YihuiCalm/Neural_Spike_Detection_and_Sorting_Circuit/schematics/simulation/amp_tb.spice

**.subckt amp_tb
VDD VDD GND 5v
v1 vbias GND 1v
Vin vin GND SIN(1 1 0.1G 0 0)
Vmeas vout net1 0
v2 vref GND 2v
XM1 GND vin net1 VDD sky130_fd_pr__pfet_g5v0d10v5 L=1 W=1 nf=1 ad='int((nf+1)/2) * W/nf * 0.29' as='int((nf+2)/2) * W/nf * 0.29'
+ pd='2*int((nf+1)/2) * (W/nf + 0.29)' ps='2*int((nf+2)/2) * (W/nf + 0.29)' nrd='0.29 / W' nrs='0.29 / W'
+ sa=0 sb=0 sd=0 mult=1 m=1 
X1 VDD vout vout vbias transamp_1
**** begin user architecture code


.control
save all
tran 1ns 50ns
plot v(vin) v(vout)
plot i(Vmeas)
.endc


 .lib /home/ubuntulab/IC/PDK/skywater-pdk/libraries/sky130_fd_pr_ngspice/latest/models/sky130.lib.spice tt

.param mc_mm_switch=0
.param mc_pr_switch=1

**** end user architecture code
**.ends

* expanding   symbol:  /media/sf_share/final_project/transamp_1.sym # of pins=4
* sym_path: /media/sf_share/final_project/transamp_1.sym
* sch_path: /media/sf_share/final_project/transamp_1.sch
.subckt transamp_1  vin_p vin_n IVout vbias
*.opin IVout
*.ipin vin_p
*.ipin vin_n
*.ipin vbias
XM1 net1 vbias GND GND sky130_fd_pr__nfet_g5v0d10v5 L=1 W=1 nf=1 ad='int((nf+1)/2) * W/nf * 0.29' as='int((nf+2)/2) * W/nf * 0.29'
+ pd='2*int((nf+1)/2) * (W/nf + 0.29)' ps='2*int((nf+2)/2) * (W/nf + 0.29)' nrd='0.29 / W' nrs='0.29 / W'
+ sa=0 sb=0 sd=0 mult=1 m=1 
XM3 net2 vin_p net1 GND sky130_fd_pr__nfet_g5v0d10v5 L=1 W=1 nf=1 ad='int((nf+1)/2) * W/nf * 0.29' as='int((nf+2)/2) * W/nf * 0.29'
+ pd='2*int((nf+1)/2) * (W/nf + 0.29)' ps='2*int((nf+2)/2) * (W/nf + 0.29)' nrd='0.29 / W' nrs='0.29 / W'
+ sa=0 sb=0 sd=0 mult=1 m=1 
XM4 IVout net2 VDD VDD sky130_fd_pr__pfet_g5v0d10v5 L=1 W=1 nf=1 ad='int((nf+1)/2) * W/nf * 0.29' as='int((nf+2)/2) * W/nf * 0.29'
+ pd='2*int((nf+1)/2) * (W/nf + 0.29)' ps='2*int((nf+2)/2) * (W/nf + 0.29)' nrd='0.29 / W' nrs='0.29 / W'
+ sa=0 sb=0 sd=0 mult=1 m=1 
XM2 IVout vin_n net1 GND sky130_fd_pr__nfet_g5v0d10v5 L=1 W=1 nf=1 ad='int((nf+1)/2) * W/nf * 0.29' as='int((nf+2)/2) * W/nf * 0.29'
+ pd='2*int((nf+1)/2) * (W/nf + 0.29)' ps='2*int((nf+2)/2) * (W/nf + 0.29)' nrd='0.29 / W' nrs='0.29 / W'
+ sa=0 sb=0 sd=0 mult=1 m=1 
XM5 net2 net2 VDD VDD sky130_fd_pr__pfet_g5v0d10v5 L=1 W=1 nf=1 ad='int((nf+1)/2) * W/nf * 0.29' as='int((nf+2)/2) * W/nf * 0.29'
+ pd='2*int((nf+1)/2) * (W/nf + 0.29)' ps='2*int((nf+2)/2) * (W/nf + 0.29)' nrd='0.29 / W' nrs='0.29 / W'
+ sa=0 sb=0 sd=0 mult=1 m=1 
.ends

.GLOBAL VDD
.GLOBAL GND
** flattened .save nodes
.save I(Vmeas)
.end
