YihuiCalm/Neural_Spike_Detection_and_Sorting_Circuit/schematics/simulation/and_tb.spice

**.subckt and_tb
Vin a GND PULSE(0 5 0 0 0 5ns 10ns)
VDD VDD GND 5v
x1 net1 a b and
Vin1 b GND PULSE(0 5 0 0 0 8ns 16ns)
x2 vout net2 schmitt_trigger
R1 net1 net2 2k m=1
R2 net2 GND 30k m=1
**** begin user architecture code


.control
save all
tran 1ns 50ns
plot v(a) v(b) v(vout)
.endc


 .lib /home/ubuntulab/IC/PDK/skywater-pdk/libraries/sky130_fd_pr_ngspice/latest/models/sky130.lib.spice tt

.param mc_mm_switch=0
.param mc_pr_switch=1

**** end user architecture code
**.ends

* expanding   symbol:  /media/sf_share/final_project/and.sym # of pins=3
* sym_path: /media/sf_share/final_project/and.sym
* sch_path: /media/sf_share/final_project/and.sch
.subckt and  vout a b
*.ipin a
*.opin vout
*.ipin b
XM1 net1 b GND GND sky130_fd_pr__nfet_g5v0d10v5 L=0.5 W=0.5 nf=1 ad='int((nf+1)/2) * W/nf * 0.29' as='int((nf+2)/2) * W/nf * 0.29'
+ pd='2*int((nf+1)/2) * (W/nf + 0.29)' ps='2*int((nf+2)/2) * (W/nf + 0.29)' nrd='0.29 / W' nrs='0.29 / W'
+ sa=0 sb=0 sd=0 mult=1 m=1 
XM5 net2 a net1 GND sky130_fd_pr__nfet_g5v0d10v5 L=0.5 W=0.5 nf=1 ad='int((nf+1)/2) * W/nf * 0.29' as='int((nf+2)/2) * W/nf * 0.29'
+ pd='2*int((nf+1)/2) * (W/nf + 0.29)' ps='2*int((nf+2)/2) * (W/nf + 0.29)' nrd='0.29 / W' nrs='0.29 / W'
+ sa=0 sb=0 sd=0 mult=1 m=1 
XM2 net2 a VDD VDD sky130_fd_pr__pfet_g5v0d10v5 L=0.5 W=0.5 nf=1 ad='int((nf+1)/2) * W/nf * 0.29' as='int((nf+2)/2) * W/nf * 0.29'
+ pd='2*int((nf+1)/2) * (W/nf + 0.29)' ps='2*int((nf+2)/2) * (W/nf + 0.29)' nrd='0.29 / W' nrs='0.29 / W'
+ sa=0 sb=0 sd=0 mult=1 m=1 
XM4 net2 b VDD VDD sky130_fd_pr__pfet_g5v0d10v5 L=0.5 W=0.5 nf=1 ad='int((nf+1)/2) * W/nf * 0.29' as='int((nf+2)/2) * W/nf * 0.29'
+ pd='2*int((nf+1)/2) * (W/nf + 0.29)' ps='2*int((nf+2)/2) * (W/nf + 0.29)' nrd='0.29 / W' nrs='0.29 / W'
+ sa=0 sb=0 sd=0 mult=1 m=1 
x1 vout net2 inverter
.ends


* expanding   symbol:  /media/sf_share/final_project/schmitt_trigger.sym # of pins=2
* sym_path: /media/sf_share/final_project/schmitt_trigger.sym
* sch_path: /media/sf_share/final_project/schmitt_trigger.sch
.subckt schmitt_trigger  vout vin
*.ipin vin
*.opin vout
XM1 net1 vin net3 GND sky130_fd_pr__nfet_g5v0d10v5 L=1 W=15 nf=1 ad='int((nf+1)/2) * W/nf * 0.29' as='int((nf+2)/2) * W/nf * 0.29'
+ pd='2*int((nf+1)/2) * (W/nf + 0.29)' ps='2*int((nf+2)/2) * (W/nf + 0.29)' nrd='0.29 / W' nrs='0.29 / W'
+ sa=0 sb=0 sd=0 mult=1 m=1 
XM2 net1 vin net2 VDD sky130_fd_pr__pfet_g5v0d10v5 L=1 W=15 nf=1 ad='int((nf+1)/2) * W/nf * 0.29' as='int((nf+2)/2) * W/nf * 0.29'
+ pd='2*int((nf+1)/2) * (W/nf + 0.29)' ps='2*int((nf+2)/2) * (W/nf + 0.29)' nrd='0.29 / W' nrs='0.29 / W'
+ sa=0 sb=0 sd=0 mult=1 m=1 
XM3 net2 vin VDD VDD sky130_fd_pr__pfet_g5v0d10v5 L=1 W=1.5 nf=1 ad='int((nf+1)/2) * W/nf * 0.29' as='int((nf+2)/2) * W/nf * 0.29'
+ pd='2*int((nf+1)/2) * (W/nf + 0.29)' ps='2*int((nf+2)/2) * (W/nf + 0.29)' nrd='0.29 / W' nrs='0.29 / W'
+ sa=0 sb=0 sd=0 mult=1 m=1 
XM4 net3 vin GND GND sky130_fd_pr__nfet_g5v0d10v5 L=1 W=1.05 nf=1 ad='int((nf+1)/2) * W/nf * 0.29' as='int((nf+2)/2) * W/nf * 0.29'
+ pd='2*int((nf+1)/2) * (W/nf + 0.29)' ps='2*int((nf+2)/2) * (W/nf + 0.29)' nrd='0.29 / W' nrs='0.29 / W'
+ sa=0 sb=0 sd=0 mult=1 m=1 
XM5 GND net1 net2 VDD sky130_fd_pr__pfet_g5v0d10v5 L=15 W=1 nf=1 ad='int((nf+1)/2) * W/nf * 0.29' as='int((nf+2)/2) * W/nf * 0.29'
+ pd='2*int((nf+1)/2) * (W/nf + 0.29)' ps='2*int((nf+2)/2) * (W/nf + 0.29)' nrd='0.29 / W' nrs='0.29 / W'
+ sa=0 sb=0 sd=0 mult=1 m=1 
XM6 VDD net1 net3 GND sky130_fd_pr__nfet_g5v0d10v5 L=5.5 W=1 nf=1 ad='int((nf+1)/2) * W/nf * 0.29' as='int((nf+2)/2) * W/nf * 0.29'
+ pd='2*int((nf+1)/2) * (W/nf + 0.29)' ps='2*int((nf+2)/2) * (W/nf + 0.29)' nrd='0.29 / W' nrs='0.29 / W'
+ sa=0 sb=0 sd=0 mult=1 m=1 
x1 vout net1 inverter
.ends


* expanding   symbol:  /media/sf_share/final_project/inverter.sym # of pins=2
* sym_path: /media/sf_share/final_project/inverter.sym
* sch_path: /media/sf_share/final_project/inverter.sch
.subckt inverter  vout vin
*.ipin vin
*.opin vout
XM3 vout vin VDD VDD sky130_fd_pr__pfet_g5v0d10v5 L=1 W=1 nf=1 ad='int((nf+1)/2) * W/nf * 0.29' as='int((nf+2)/2) * W/nf * 0.29'
+ pd='2*int((nf+1)/2) * (W/nf + 0.29)' ps='2*int((nf+2)/2) * (W/nf + 0.29)' nrd='0.29 / W' nrs='0.29 / W'
+ sa=0 sb=0 sd=0 mult=1 m=1 
XM5 vout vin GND GND sky130_fd_pr__nfet_g5v0d10v5 L=1 W=1 nf=1 ad='int((nf+1)/2) * W/nf * 0.29' as='int((nf+2)/2) * W/nf * 0.29'
+ pd='2*int((nf+1)/2) * (W/nf + 0.29)' ps='2*int((nf+2)/2) * (W/nf + 0.29)' nrd='0.29 / W' nrs='0.29 / W'
+ sa=0 sb=0 sd=0 mult=1 m=1 
.ends

.GLOBAL VDD
.GLOBAL GND
** flattened .save nodes
.end
