YihuiCalm/Neural_Spike_Detection_and_Sorting_Circuit/schematics/simulation/bump_WTA_tb.spice

**.subckt bump_WTA_tb
V2 net39 GND 5.0
V5 HPbias GND 0.4
V6 VREF GND 2.0
V3 LPbias1 GND 0.543v
V4 LPbias2 GND 0.4v
Vbias5 vbias_bump GND 3v
Vbias6 vbias_WTA GND 3v
x6 vin_1 net1 HPbias VREF Highpass_500Hz
x7 LPbias2 net1 vfilter_1 LPbias1 Lowpass_2500Hz
x8 vspike_1 vfilter_1 schmitt_trigger
x9 vin_2 net2 HPbias VREF Highpass_500Hz
x10 LPbias2 net2 vfilter_2 LPbias1 Lowpass_2500Hz
x11 vspike_2 vfilter_2 schmitt_trigger
x12 vin_3 net3 HPbias VREF Highpass_500Hz
x13 LPbias2 net3 vfilter_3 LPbias1 Lowpass_2500Hz
x14 vspike_3 vfilter_3 schmitt_trigger
x15 vin_4 net4 HPbias VREF Highpass_500Hz
x16 LPbias2 net4 vfilter_4 LPbias1 Lowpass_2500Hz
x17 vspike_4 vfilter_4 schmitt_trigger
x18 vmem_1_1 vg_1 vspike_1 vbias vbias1 vbias2 cap_mem
x1 vmem_2_1 vg_1 vspike_2 vbias vbias1 vbias2 cap_mem
x2 vmem_3_1 vg_1 vspike_3 vbias vbias1 vbias2 cap_mem
x3 vmem_4_1 vg_1 vspike_4 vbias vbias1 vbias2 cap_mem
Vmeas_bump_1 net40 net5 0
XM8 net5 net6 GND GND sky130_fd_pr__nfet_g5v0d10v5 L=1 W=1 nf=1 ad='int((nf+1)/2) * W/nf * 0.29' as='int((nf+2)/2) * W/nf * 0.29'
+ pd='2*int((nf+1)/2) * (W/nf + 0.29)' ps='2*int((nf+2)/2) * (W/nf + 0.29)' nrd='0.29 / W' nrs='0.29 / W'
+ sa=0 sb=0 sd=0 mult=1 m=1 
XM9 VDD net5 net6 GND sky130_fd_pr__nfet_g5v0d10v5 L=1 W=1 nf=1 ad='int((nf+1)/2) * W/nf * 0.29' as='int((nf+2)/2) * W/nf * 0.29'
+ pd='2*int((nf+1)/2) * (W/nf + 0.29)' ps='2*int((nf+2)/2) * (W/nf + 0.29)' nrd='0.29 / W' nrs='0.29 / W'
+ sa=0 sb=0 sd=0 mult=1 m=1 
XM10 net7 net8 GND GND sky130_fd_pr__nfet_g5v0d10v5 L=1 W=1 nf=1 ad='int((nf+1)/2) * W/nf * 0.29' as='int((nf+2)/2) * W/nf * 0.29'
+ pd='2*int((nf+1)/2) * (W/nf + 0.29)' ps='2*int((nf+2)/2) * (W/nf + 0.29)' nrd='0.29 / W' nrs='0.29 / W'
+ sa=0 sb=0 sd=0 mult=1 m=1 
XM11 VDD net7 net8 GND sky130_fd_pr__nfet_g5v0d10v5 L=1 W=1 nf=1 ad='int((nf+1)/2) * W/nf * 0.29' as='int((nf+2)/2) * W/nf * 0.29'
+ pd='2*int((nf+1)/2) * (W/nf + 0.29)' ps='2*int((nf+2)/2) * (W/nf + 0.29)' nrd='0.29 / W' nrs='0.29 / W'
+ sa=0 sb=0 sd=0 mult=1 m=1 
I0 VDD net7 8uA
XM12 net10 vbias_WTA GND GND sky130_fd_pr__nfet_g5v0d10v5 L=1 W=1 nf=1 ad='int((nf+1)/2) * W/nf * 0.29'
+ as='int((nf+2)/2) * W/nf * 0.29' pd='2*int((nf+1)/2) * (W/nf + 0.29)' ps='2*int((nf+2)/2) * (W/nf + 0.29)'
+ nrd='0.29 / W' nrs='0.29 / W' sa=0 sb=0 sd=0 mult=1 m=1 
Vmeas_in_1 net6 net9 0
Vmeas_ref net8 net9 0
Vmeas_bais net9 net10 0
x5 vmem_1_1 vnxor_1_1 vspike_1 nxor
XM6 net12 VDD net13 GND sky130_fd_pr__nfet_g5v0d10v5 L=1 W=0.5 nf=1 ad='int((nf+1)/2) * W/nf * 0.29'
+ as='int((nf+2)/2) * W/nf * 0.29' pd='2*int((nf+1)/2) * (W/nf + 0.29)' ps='2*int((nf+2)/2) * (W/nf + 0.29)'
+ nrd='0.29 / W' nrs='0.29 / W' sa=0 sb=0 sd=0 mult=1 m=1 
XM7 VDD vand_1 net11 GND sky130_fd_pr__nfet_g5v0d10v5 L=1 W=1 nf=1 ad='int((nf+1)/2) * W/nf * 0.29' as='int((nf+2)/2) * W/nf * 0.29'
+ pd='2*int((nf+1)/2) * (W/nf + 0.29)' ps='2*int((nf+2)/2) * (W/nf + 0.29)' nrd='0.29 / W' nrs='0.29 / W'
+ sa=0 sb=0 sd=0 mult=1 m=1 
XM2 net13 vand_1 net11 GND sky130_fd_pr__nfet_g5v0d10v5 L=1 W=0.5 nf=1 ad='int((nf+1)/2) * W/nf * 0.29'
+ as='int((nf+2)/2) * W/nf * 0.29' pd='2*int((nf+1)/2) * (W/nf + 0.29)' ps='2*int((nf+2)/2) * (W/nf + 0.29)'
+ nrd='0.29 / W' nrs='0.29 / W' sa=0 sb=0 sd=0 mult=1 m=1 
XM3 VDD VDD net11 GND sky130_fd_pr__nfet_g5v0d10v5 L=1 W=1 nf=1 ad='int((nf+1)/2) * W/nf * 0.29' as='int((nf+2)/2) * W/nf * 0.29'
+ pd='2*int((nf+1)/2) * (W/nf + 0.29)' ps='2*int((nf+2)/2) * (W/nf + 0.29)' nrd='0.29 / W' nrs='0.29 / W'
+ sa=0 sb=0 sd=0 mult=1 m=1 
XM4 net11 vbias_bump GND GND sky130_fd_pr__nfet_g5v0d10v5 L=1 W=1 nf=1 ad='int((nf+1)/2) * W/nf * 0.29'
+ as='int((nf+2)/2) * W/nf * 0.29' pd='2*int((nf+1)/2) * (W/nf + 0.29)' ps='2*int((nf+2)/2) * (W/nf + 0.29)'
+ nrd='0.29 / W' nrs='0.29 / W' sa=0 sb=0 sd=0 mult=1 m=1 
XM5 net12 net12 VDD VDD sky130_fd_pr__pfet_g5v0d10v5 L=1 W=1 nf=1 ad='int((nf+1)/2) * W/nf * 0.29' as='int((nf+2)/2) * W/nf * 0.29'
+ pd='2*int((nf+1)/2) * (W/nf + 0.29)' ps='2*int((nf+2)/2) * (W/nf + 0.29)' nrd='0.29 / W' nrs='0.29 / W'
+ sa=0 sb=0 sd=0 mult=1 m=1 
XM1 net40 net12 VDD VDD sky130_fd_pr__pfet_g5v0d10v5 L=1 W=1 nf=1 ad='int((nf+1)/2) * W/nf * 0.29' as='int((nf+2)/2) * W/nf * 0.29'
+ pd='2*int((nf+1)/2) * (W/nf + 0.29)' ps='2*int((nf+2)/2) * (W/nf + 0.29)' nrd='0.29 / W' nrs='0.29 / W'
+ sa=0 sb=0 sd=0 mult=1 m=1 
Vbias3 vbias GND 2v
Vbias9 vbias1 GND 2v
Vbias10 vbias2 GND 1.1v
x19 vmem_2_1 vnxor_2_1 vspike_2 nxor
x20 vmem_3_1 vnxor_3_1 vspike_3 nxor
x21 vmem_4_1 vnxor_4_1 vspike_4 nxor
x22 vand_1 vnxor_1_1 vnxor_2_1 vnxor_3_1 vnxor_4_1 VDD and5
Vmeas_bump_2 net41 net14 0
XM13 net14 net15 GND GND sky130_fd_pr__nfet_g5v0d10v5 L=1 W=1 nf=1 ad='int((nf+1)/2) * W/nf * 0.29' as='int((nf+2)/2) * W/nf * 0.29'
+ pd='2*int((nf+1)/2) * (W/nf + 0.29)' ps='2*int((nf+2)/2) * (W/nf + 0.29)' nrd='0.29 / W' nrs='0.29 / W'
+ sa=0 sb=0 sd=0 mult=1 m=1 
XM14 VDD net14 net15 GND sky130_fd_pr__nfet_g5v0d10v5 L=1 W=1 nf=1 ad='int((nf+1)/2) * W/nf * 0.29' as='int((nf+2)/2) * W/nf * 0.29'
+ pd='2*int((nf+1)/2) * (W/nf + 0.29)' ps='2*int((nf+2)/2) * (W/nf + 0.29)' nrd='0.29 / W' nrs='0.29 / W'
+ sa=0 sb=0 sd=0 mult=1 m=1 
Vmeas_in_2 net15 net9 0
x4 vmem_1_2 vnxor_1_2 vspike_1 nxor
XM15 net17 VDD net18 GND sky130_fd_pr__nfet_g5v0d10v5 L=1 W=0.5 nf=1 ad='int((nf+1)/2) * W/nf * 0.29'
+ as='int((nf+2)/2) * W/nf * 0.29' pd='2*int((nf+1)/2) * (W/nf + 0.29)' ps='2*int((nf+2)/2) * (W/nf + 0.29)'
+ nrd='0.29 / W' nrs='0.29 / W' sa=0 sb=0 sd=0 mult=1 m=1 
XM16 VDD vand_2 net16 GND sky130_fd_pr__nfet_g5v0d10v5 L=1 W=1 nf=1 ad='int((nf+1)/2) * W/nf * 0.29'
+ as='int((nf+2)/2) * W/nf * 0.29' pd='2*int((nf+1)/2) * (W/nf + 0.29)' ps='2*int((nf+2)/2) * (W/nf + 0.29)'
+ nrd='0.29 / W' nrs='0.29 / W' sa=0 sb=0 sd=0 mult=1 m=1 
XM17 net18 vand_2 net16 GND sky130_fd_pr__nfet_g5v0d10v5 L=1 W=0.5 nf=1 ad='int((nf+1)/2) * W/nf * 0.29'
+ as='int((nf+2)/2) * W/nf * 0.29' pd='2*int((nf+1)/2) * (W/nf + 0.29)' ps='2*int((nf+2)/2) * (W/nf + 0.29)'
+ nrd='0.29 / W' nrs='0.29 / W' sa=0 sb=0 sd=0 mult=1 m=1 
XM18 VDD VDD net16 GND sky130_fd_pr__nfet_g5v0d10v5 L=1 W=1 nf=1 ad='int((nf+1)/2) * W/nf * 0.29' as='int((nf+2)/2) * W/nf * 0.29'
+ pd='2*int((nf+1)/2) * (W/nf + 0.29)' ps='2*int((nf+2)/2) * (W/nf + 0.29)' nrd='0.29 / W' nrs='0.29 / W'
+ sa=0 sb=0 sd=0 mult=1 m=1 
XM19 net16 vbias_bump GND GND sky130_fd_pr__nfet_g5v0d10v5 L=1 W=1 nf=1 ad='int((nf+1)/2) * W/nf * 0.29'
+ as='int((nf+2)/2) * W/nf * 0.29' pd='2*int((nf+1)/2) * (W/nf + 0.29)' ps='2*int((nf+2)/2) * (W/nf + 0.29)'
+ nrd='0.29 / W' nrs='0.29 / W' sa=0 sb=0 sd=0 mult=1 m=1 
XM20 net17 net17 VDD VDD sky130_fd_pr__pfet_g5v0d10v5 L=1 W=1 nf=1 ad='int((nf+1)/2) * W/nf * 0.29' as='int((nf+2)/2) * W/nf * 0.29'
+ pd='2*int((nf+1)/2) * (W/nf + 0.29)' ps='2*int((nf+2)/2) * (W/nf + 0.29)' nrd='0.29 / W' nrs='0.29 / W'
+ sa=0 sb=0 sd=0 mult=1 m=1 
XM21 net41 net17 VDD VDD sky130_fd_pr__pfet_g5v0d10v5 L=1 W=1 nf=1 ad='int((nf+1)/2) * W/nf * 0.29' as='int((nf+2)/2) * W/nf * 0.29'
+ pd='2*int((nf+1)/2) * (W/nf + 0.29)' ps='2*int((nf+2)/2) * (W/nf + 0.29)' nrd='0.29 / W' nrs='0.29 / W'
+ sa=0 sb=0 sd=0 mult=1 m=1 
x24 vmem_2_2 vnxor_2_2 vspike_2 nxor
x25 vmem_3_2 vnxor_3_2 vspike_3 nxor
x26 vmem_4_2 vnxor_4_2 vspike_4 nxor
x27 vand_2 vnxor_1_2 vnxor_2_2 vnxor_3_2 vnxor_4_2 VDD and5
x23 vmem_1_2 vg_2 vspike_1 vbias vbias1 vbias2 cap_mem
x28 vmem_2_2 vg_2 vspike_2 vbias vbias1 vbias2 cap_mem
x29 vmem_3_2 vg_2 vspike_3 vbias vbias1 vbias2 cap_mem
x30 vmem_4_2 vg_2 vspike_4 vbias vbias1 vbias2 cap_mem
Vmeas_bump_3 net42 net19 0
XM22 net19 net20 GND GND sky130_fd_pr__nfet_g5v0d10v5 L=1 W=1 nf=1 ad='int((nf+1)/2) * W/nf * 0.29' as='int((nf+2)/2) * W/nf * 0.29'
+ pd='2*int((nf+1)/2) * (W/nf + 0.29)' ps='2*int((nf+2)/2) * (W/nf + 0.29)' nrd='0.29 / W' nrs='0.29 / W'
+ sa=0 sb=0 sd=0 mult=1 m=1 
XM23 VDD net19 net20 GND sky130_fd_pr__nfet_g5v0d10v5 L=1 W=1 nf=1 ad='int((nf+1)/2) * W/nf * 0.29' as='int((nf+2)/2) * W/nf * 0.29'
+ pd='2*int((nf+1)/2) * (W/nf + 0.29)' ps='2*int((nf+2)/2) * (W/nf + 0.29)' nrd='0.29 / W' nrs='0.29 / W'
+ sa=0 sb=0 sd=0 mult=1 m=1 
Vmeas_in_3 net20 net9 0
x31 vmem_1_3 vnxor_1_3 vspike_1 nxor
XM24 net22 VDD net23 GND sky130_fd_pr__nfet_g5v0d10v5 L=1 W=0.5 nf=1 ad='int((nf+1)/2) * W/nf * 0.29'
+ as='int((nf+2)/2) * W/nf * 0.29' pd='2*int((nf+1)/2) * (W/nf + 0.29)' ps='2*int((nf+2)/2) * (W/nf + 0.29)'
+ nrd='0.29 / W' nrs='0.29 / W' sa=0 sb=0 sd=0 mult=1 m=1 
XM25 VDD vand_3 net21 GND sky130_fd_pr__nfet_g5v0d10v5 L=1 W=1 nf=1 ad='int((nf+1)/2) * W/nf * 0.29'
+ as='int((nf+2)/2) * W/nf * 0.29' pd='2*int((nf+1)/2) * (W/nf + 0.29)' ps='2*int((nf+2)/2) * (W/nf + 0.29)'
+ nrd='0.29 / W' nrs='0.29 / W' sa=0 sb=0 sd=0 mult=1 m=1 
XM26 net23 vand_3 net21 GND sky130_fd_pr__nfet_g5v0d10v5 L=1 W=0.5 nf=1 ad='int((nf+1)/2) * W/nf * 0.29'
+ as='int((nf+2)/2) * W/nf * 0.29' pd='2*int((nf+1)/2) * (W/nf + 0.29)' ps='2*int((nf+2)/2) * (W/nf + 0.29)'
+ nrd='0.29 / W' nrs='0.29 / W' sa=0 sb=0 sd=0 mult=1 m=1 
XM27 VDD VDD net21 GND sky130_fd_pr__nfet_g5v0d10v5 L=1 W=1 nf=1 ad='int((nf+1)/2) * W/nf * 0.29' as='int((nf+2)/2) * W/nf * 0.29'
+ pd='2*int((nf+1)/2) * (W/nf + 0.29)' ps='2*int((nf+2)/2) * (W/nf + 0.29)' nrd='0.29 / W' nrs='0.29 / W'
+ sa=0 sb=0 sd=0 mult=1 m=1 
XM28 net21 vbias_bump GND GND sky130_fd_pr__nfet_g5v0d10v5 L=1 W=1 nf=1 ad='int((nf+1)/2) * W/nf * 0.29'
+ as='int((nf+2)/2) * W/nf * 0.29' pd='2*int((nf+1)/2) * (W/nf + 0.29)' ps='2*int((nf+2)/2) * (W/nf + 0.29)'
+ nrd='0.29 / W' nrs='0.29 / W' sa=0 sb=0 sd=0 mult=1 m=1 
XM29 net22 net22 VDD VDD sky130_fd_pr__pfet_g5v0d10v5 L=1 W=1 nf=1 ad='int((nf+1)/2) * W/nf * 0.29' as='int((nf+2)/2) * W/nf * 0.29'
+ pd='2*int((nf+1)/2) * (W/nf + 0.29)' ps='2*int((nf+2)/2) * (W/nf + 0.29)' nrd='0.29 / W' nrs='0.29 / W'
+ sa=0 sb=0 sd=0 mult=1 m=1 
XM30 net42 net22 VDD VDD sky130_fd_pr__pfet_g5v0d10v5 L=1 W=1 nf=1 ad='int((nf+1)/2) * W/nf * 0.29' as='int((nf+2)/2) * W/nf * 0.29'
+ pd='2*int((nf+1)/2) * (W/nf + 0.29)' ps='2*int((nf+2)/2) * (W/nf + 0.29)' nrd='0.29 / W' nrs='0.29 / W'
+ sa=0 sb=0 sd=0 mult=1 m=1 
x32 vmem_2_3 vnxor_2_3 vspike_2 nxor
x33 vmem_3_3 vnxor_3_3 vspike_3 nxor
x34 vmem_4_3 vnxor_4_3 vspike_4 nxor
x35 vand_3 vnxor_1_3 vnxor_2_3 vnxor_3_3 vnxor_4_3 VDD and5
Vmeas_bump_4 net43 net24 0
XM31 net24 net25 GND GND sky130_fd_pr__nfet_g5v0d10v5 L=1 W=1 nf=1 ad='int((nf+1)/2) * W/nf * 0.29' as='int((nf+2)/2) * W/nf * 0.29'
+ pd='2*int((nf+1)/2) * (W/nf + 0.29)' ps='2*int((nf+2)/2) * (W/nf + 0.29)' nrd='0.29 / W' nrs='0.29 / W'
+ sa=0 sb=0 sd=0 mult=1 m=1 
XM32 VDD net24 net25 GND sky130_fd_pr__nfet_g5v0d10v5 L=1 W=1 nf=1 ad='int((nf+1)/2) * W/nf * 0.29' as='int((nf+2)/2) * W/nf * 0.29'
+ pd='2*int((nf+1)/2) * (W/nf + 0.29)' ps='2*int((nf+2)/2) * (W/nf + 0.29)' nrd='0.29 / W' nrs='0.29 / W'
+ sa=0 sb=0 sd=0 mult=1 m=1 
Vmeas_in_4 net25 net9 0
x36 vmem_1_4 vnxor_1_4 vspike_1 nxor
XM33 net27 VDD net28 GND sky130_fd_pr__nfet_g5v0d10v5 L=1 W=0.5 nf=1 ad='int((nf+1)/2) * W/nf * 0.29'
+ as='int((nf+2)/2) * W/nf * 0.29' pd='2*int((nf+1)/2) * (W/nf + 0.29)' ps='2*int((nf+2)/2) * (W/nf + 0.29)'
+ nrd='0.29 / W' nrs='0.29 / W' sa=0 sb=0 sd=0 mult=1 m=1 
XM34 VDD vand_4 net26 GND sky130_fd_pr__nfet_g5v0d10v5 L=1 W=1 nf=1 ad='int((nf+1)/2) * W/nf * 0.29'
+ as='int((nf+2)/2) * W/nf * 0.29' pd='2*int((nf+1)/2) * (W/nf + 0.29)' ps='2*int((nf+2)/2) * (W/nf + 0.29)'
+ nrd='0.29 / W' nrs='0.29 / W' sa=0 sb=0 sd=0 mult=1 m=1 
XM35 net28 vand_4 net26 GND sky130_fd_pr__nfet_g5v0d10v5 L=1 W=0.5 nf=1 ad='int((nf+1)/2) * W/nf * 0.29'
+ as='int((nf+2)/2) * W/nf * 0.29' pd='2*int((nf+1)/2) * (W/nf + 0.29)' ps='2*int((nf+2)/2) * (W/nf + 0.29)'
+ nrd='0.29 / W' nrs='0.29 / W' sa=0 sb=0 sd=0 mult=1 m=1 
XM36 VDD VDD net26 GND sky130_fd_pr__nfet_g5v0d10v5 L=1 W=1 nf=1 ad='int((nf+1)/2) * W/nf * 0.29' as='int((nf+2)/2) * W/nf * 0.29'
+ pd='2*int((nf+1)/2) * (W/nf + 0.29)' ps='2*int((nf+2)/2) * (W/nf + 0.29)' nrd='0.29 / W' nrs='0.29 / W'
+ sa=0 sb=0 sd=0 mult=1 m=1 
XM37 net26 vbias_bump GND GND sky130_fd_pr__nfet_g5v0d10v5 L=1 W=1 nf=1 ad='int((nf+1)/2) * W/nf * 0.29'
+ as='int((nf+2)/2) * W/nf * 0.29' pd='2*int((nf+1)/2) * (W/nf + 0.29)' ps='2*int((nf+2)/2) * (W/nf + 0.29)'
+ nrd='0.29 / W' nrs='0.29 / W' sa=0 sb=0 sd=0 mult=1 m=1 
XM38 net27 net27 VDD VDD sky130_fd_pr__pfet_g5v0d10v5 L=1 W=1 nf=1 ad='int((nf+1)/2) * W/nf * 0.29' as='int((nf+2)/2) * W/nf * 0.29'
+ pd='2*int((nf+1)/2) * (W/nf + 0.29)' ps='2*int((nf+2)/2) * (W/nf + 0.29)' nrd='0.29 / W' nrs='0.29 / W'
+ sa=0 sb=0 sd=0 mult=1 m=1 
XM39 net43 net27 VDD VDD sky130_fd_pr__pfet_g5v0d10v5 L=1 W=1 nf=1 ad='int((nf+1)/2) * W/nf * 0.29' as='int((nf+2)/2) * W/nf * 0.29'
+ pd='2*int((nf+1)/2) * (W/nf + 0.29)' ps='2*int((nf+2)/2) * (W/nf + 0.29)' nrd='0.29 / W' nrs='0.29 / W'
+ sa=0 sb=0 sd=0 mult=1 m=1 
x37 vmem_2_4 vnxor_2_4 vspike_2 nxor
x38 vmem_3_4 vnxor_3_4 vspike_3 nxor
x39 vmem_4_4 vnxor_4_4 vspike_4 nxor
x40 vand_4 vnxor_1_4 vnxor_2_4 vnxor_3_4 vnxor_4_4 VDD and5
x41 vmem_1_3 vg_3 vspike_1 vbias vbias1 vbias2 cap_mem
x42 vmem_2_3 vg_3 vspike_2 vbias vbias1 vbias2 cap_mem
x43 vmem_3_3 vg_3 vspike_3 vbias vbias1 vbias2 cap_mem
x44 vmem_4_3 vg_3 vspike_4 vbias vbias1 vbias2 cap_mem
x45 vmem_1_4 vg_4 vspike_1 vbias vbias1 vbias2 cap_mem
x46 vmem_2_4 vg_4 vspike_2 vbias vbias1 vbias2 cap_mem
x47 vmem_3_4 vg_4 vspike_3 vbias vbias1 vbias2 cap_mem
x48 vmem_4_4 vg_4 vspike_4 vbias vbias1 vbias2 cap_mem
Vmeas_bump_5 net44 net29 0
XM40 net29 net30 GND GND sky130_fd_pr__nfet_g5v0d10v5 L=1 W=1 nf=1 ad='int((nf+1)/2) * W/nf * 0.29' as='int((nf+2)/2) * W/nf * 0.29'
+ pd='2*int((nf+1)/2) * (W/nf + 0.29)' ps='2*int((nf+2)/2) * (W/nf + 0.29)' nrd='0.29 / W' nrs='0.29 / W'
+ sa=0 sb=0 sd=0 mult=1 m=1 
XM41 VDD net29 net30 GND sky130_fd_pr__nfet_g5v0d10v5 L=1 W=1 nf=1 ad='int((nf+1)/2) * W/nf * 0.29' as='int((nf+2)/2) * W/nf * 0.29'
+ pd='2*int((nf+1)/2) * (W/nf + 0.29)' ps='2*int((nf+2)/2) * (W/nf + 0.29)' nrd='0.29 / W' nrs='0.29 / W'
+ sa=0 sb=0 sd=0 mult=1 m=1 
Vmeas_in_6 net30 net9 0
x49 vmem_1_5 vnxor_1_5 vspike_1 nxor
XM42 net32 VDD net33 GND sky130_fd_pr__nfet_g5v0d10v5 L=1 W=0.5 nf=1 ad='int((nf+1)/2) * W/nf * 0.29'
+ as='int((nf+2)/2) * W/nf * 0.29' pd='2*int((nf+1)/2) * (W/nf + 0.29)' ps='2*int((nf+2)/2) * (W/nf + 0.29)'
+ nrd='0.29 / W' nrs='0.29 / W' sa=0 sb=0 sd=0 mult=1 m=1 
XM43 VDD vand_5 net31 GND sky130_fd_pr__nfet_g5v0d10v5 L=1 W=1 nf=1 ad='int((nf+1)/2) * W/nf * 0.29'
+ as='int((nf+2)/2) * W/nf * 0.29' pd='2*int((nf+1)/2) * (W/nf + 0.29)' ps='2*int((nf+2)/2) * (W/nf + 0.29)'
+ nrd='0.29 / W' nrs='0.29 / W' sa=0 sb=0 sd=0 mult=1 m=1 
XM44 net33 vand_5 net31 GND sky130_fd_pr__nfet_g5v0d10v5 L=1 W=0.5 nf=1 ad='int((nf+1)/2) * W/nf * 0.29'
+ as='int((nf+2)/2) * W/nf * 0.29' pd='2*int((nf+1)/2) * (W/nf + 0.29)' ps='2*int((nf+2)/2) * (W/nf + 0.29)'
+ nrd='0.29 / W' nrs='0.29 / W' sa=0 sb=0 sd=0 mult=1 m=1 
XM45 VDD VDD net31 GND sky130_fd_pr__nfet_g5v0d10v5 L=1 W=1 nf=1 ad='int((nf+1)/2) * W/nf * 0.29' as='int((nf+2)/2) * W/nf * 0.29'
+ pd='2*int((nf+1)/2) * (W/nf + 0.29)' ps='2*int((nf+2)/2) * (W/nf + 0.29)' nrd='0.29 / W' nrs='0.29 / W'
+ sa=0 sb=0 sd=0 mult=1 m=1 
XM46 net31 vbias_bump GND GND sky130_fd_pr__nfet_g5v0d10v5 L=1 W=1 nf=1 ad='int((nf+1)/2) * W/nf * 0.29'
+ as='int((nf+2)/2) * W/nf * 0.29' pd='2*int((nf+1)/2) * (W/nf + 0.29)' ps='2*int((nf+2)/2) * (W/nf + 0.29)'
+ nrd='0.29 / W' nrs='0.29 / W' sa=0 sb=0 sd=0 mult=1 m=1 
XM47 net32 net32 VDD VDD sky130_fd_pr__pfet_g5v0d10v5 L=1 W=1 nf=1 ad='int((nf+1)/2) * W/nf * 0.29' as='int((nf+2)/2) * W/nf * 0.29'
+ pd='2*int((nf+1)/2) * (W/nf + 0.29)' ps='2*int((nf+2)/2) * (W/nf + 0.29)' nrd='0.29 / W' nrs='0.29 / W'
+ sa=0 sb=0 sd=0 mult=1 m=1 
XM48 net44 net32 VDD VDD sky130_fd_pr__pfet_g5v0d10v5 L=1 W=1 nf=1 ad='int((nf+1)/2) * W/nf * 0.29' as='int((nf+2)/2) * W/nf * 0.29'
+ pd='2*int((nf+1)/2) * (W/nf + 0.29)' ps='2*int((nf+2)/2) * (W/nf + 0.29)' nrd='0.29 / W' nrs='0.29 / W'
+ sa=0 sb=0 sd=0 mult=1 m=1 
x50 vmem_2_5 vnxor_2_5 vspike_2 nxor
x51 vmem_3_5 vnxor_3_5 vspike_3 nxor
x52 vmem_4_5 vnxor_4_5 vspike_4 nxor
x53 vand_5 vnxor_1_5 vnxor_2_5 vnxor_3_5 vnxor_4_5 VDD and5
Vmeas_bump_6 net45 net34 0
XM49 net34 net35 GND GND sky130_fd_pr__nfet_g5v0d10v5 L=1 W=1 nf=1 ad='int((nf+1)/2) * W/nf * 0.29' as='int((nf+2)/2) * W/nf * 0.29'
+ pd='2*int((nf+1)/2) * (W/nf + 0.29)' ps='2*int((nf+2)/2) * (W/nf + 0.29)' nrd='0.29 / W' nrs='0.29 / W'
+ sa=0 sb=0 sd=0 mult=1 m=1 
XM50 VDD net34 net35 GND sky130_fd_pr__nfet_g5v0d10v5 L=1 W=1 nf=1 ad='int((nf+1)/2) * W/nf * 0.29' as='int((nf+2)/2) * W/nf * 0.29'
+ pd='2*int((nf+1)/2) * (W/nf + 0.29)' ps='2*int((nf+2)/2) * (W/nf + 0.29)' nrd='0.29 / W' nrs='0.29 / W'
+ sa=0 sb=0 sd=0 mult=1 m=1 
Vmeas_in_5 net35 net9 0
x54 vmem_1_6 vnxor_1_6 vspike_1 nxor
XM51 net37 VDD net38 GND sky130_fd_pr__nfet_g5v0d10v5 L=1 W=0.5 nf=1 ad='int((nf+1)/2) * W/nf * 0.29'
+ as='int((nf+2)/2) * W/nf * 0.29' pd='2*int((nf+1)/2) * (W/nf + 0.29)' ps='2*int((nf+2)/2) * (W/nf + 0.29)'
+ nrd='0.29 / W' nrs='0.29 / W' sa=0 sb=0 sd=0 mult=1 m=1 
XM52 VDD vand_6 net36 GND sky130_fd_pr__nfet_g5v0d10v5 L=1 W=1 nf=1 ad='int((nf+1)/2) * W/nf * 0.29'
+ as='int((nf+2)/2) * W/nf * 0.29' pd='2*int((nf+1)/2) * (W/nf + 0.29)' ps='2*int((nf+2)/2) * (W/nf + 0.29)'
+ nrd='0.29 / W' nrs='0.29 / W' sa=0 sb=0 sd=0 mult=1 m=1 
XM53 net38 vand_6 net36 GND sky130_fd_pr__nfet_g5v0d10v5 L=1 W=0.5 nf=1 ad='int((nf+1)/2) * W/nf * 0.29'
+ as='int((nf+2)/2) * W/nf * 0.29' pd='2*int((nf+1)/2) * (W/nf + 0.29)' ps='2*int((nf+2)/2) * (W/nf + 0.29)'
+ nrd='0.29 / W' nrs='0.29 / W' sa=0 sb=0 sd=0 mult=1 m=1 
XM54 VDD VDD net36 GND sky130_fd_pr__nfet_g5v0d10v5 L=1 W=1 nf=1 ad='int((nf+1)/2) * W/nf * 0.29' as='int((nf+2)/2) * W/nf * 0.29'
+ pd='2*int((nf+1)/2) * (W/nf + 0.29)' ps='2*int((nf+2)/2) * (W/nf + 0.29)' nrd='0.29 / W' nrs='0.29 / W'
+ sa=0 sb=0 sd=0 mult=1 m=1 
XM55 net36 vbias_bump GND GND sky130_fd_pr__nfet_g5v0d10v5 L=1 W=1 nf=1 ad='int((nf+1)/2) * W/nf * 0.29'
+ as='int((nf+2)/2) * W/nf * 0.29' pd='2*int((nf+1)/2) * (W/nf + 0.29)' ps='2*int((nf+2)/2) * (W/nf + 0.29)'
+ nrd='0.29 / W' nrs='0.29 / W' sa=0 sb=0 sd=0 mult=1 m=1 
XM56 net37 net37 VDD VDD sky130_fd_pr__pfet_g5v0d10v5 L=1 W=1 nf=1 ad='int((nf+1)/2) * W/nf * 0.29' as='int((nf+2)/2) * W/nf * 0.29'
+ pd='2*int((nf+1)/2) * (W/nf + 0.29)' ps='2*int((nf+2)/2) * (W/nf + 0.29)' nrd='0.29 / W' nrs='0.29 / W'
+ sa=0 sb=0 sd=0 mult=1 m=1 
XM57 net45 net37 VDD VDD sky130_fd_pr__pfet_g5v0d10v5 L=1 W=1 nf=1 ad='int((nf+1)/2) * W/nf * 0.29' as='int((nf+2)/2) * W/nf * 0.29'
+ pd='2*int((nf+1)/2) * (W/nf + 0.29)' ps='2*int((nf+2)/2) * (W/nf + 0.29)' nrd='0.29 / W' nrs='0.29 / W'
+ sa=0 sb=0 sd=0 mult=1 m=1 
x55 vmem_2_6 vnxor_2_6 vspike_2 nxor
x56 vmem_3_6 vnxor_3_6 vspike_3 nxor
x57 vmem_4_6 vnxor_4_6 vspike_4 nxor
x58 vand_6 vnxor_1_6 vnxor_2_6 vnxor_3_6 vnxor_4_6 VDD and5
x59 vmem_1_5 vg_5 vspike_1 vbias vbias1 vbias2 cap_mem
x60 vmem_2_5 vg_5 vspike_2 vbias vbias1 vbias2 cap_mem
x61 vmem_3_5 vg_5 vspike_3 vbias vbias1 vbias2 cap_mem
x62 vmem_4_5 vg_5 vspike_4 vbias vbias1 vbias2 cap_mem
x63 vmem_1_6 vg_6 vspike_1 vbias vbias1 vbias2 cap_mem
x64 vmem_2_6 vg_6 vspike_2 vbias vbias1 vbias2 cap_mem
x65 vmem_3_6 vg_6 vspike_3 vbias vbias1 vbias2 cap_mem
x66 vmem_4_6 vg_6 vspike_4 vbias vbias1 vbias2 cap_mem
x67 vout_1 net5 buffer
x68 vout_2 net14 buffer
x69 vout_3 net19 buffer
x70 vout_4 net24 buffer
x71 vout_5 net29 buffer
x72 vout_6 net34 buffer
Vmeas VDD net39 0
**** begin user architecture code
 .lib /home/ubuntulab/IC/PDK/skywater-pdk/libraries/sky130_fd_pr_ngspice/latest/models/sky130.lib.spice tt

.param mc_mm_switch=0
.param mc_pr_switch=1



.model fsrc1 filesource(file="data/eval_dataset/electrode_ch1.txt" timeoffset=0 timescale=1
+ amploffset=[0] amplscale=[1.0] timerelative=false amplstep=false)
a1 %v[vin_1] fsrc1
.model fsrc2 filesource(file="data/eval_dataset/electrode_ch2.txt" timeoffset=0 timescale=1
+ amploffset=[0] amplscale=[1.0] timerelative=false amplstep=false)
a2 %v[vin_2] fsrc2
.model fsrc3 filesource(file="data/eval_dataset/electrode_ch3.txt" timeoffset=0 timescale=1
+ amploffset=[0] amplscale=[1.0] timerelative=false amplstep=false)
a3 %v[vin_3] fsrc3
.model fsrc4 filesource(file="data/eval_dataset/electrode_ch4.txt" timeoffset=0 timescale=1
+ amploffset=[0] amplscale=[1.0] timerelative=false amplstep=false)
a4 %v[vin_4] fsrc4
.model fsrc5 filesource(file="data/eval_dataset/teach_ch1.txt" timeoffset=0 timescale=1
+ amploffset=[0] amplscale=[1.0] timerelative=false amplstep=false)
a5 %v[vg_1] fsrc5
.model fsrc6 filesource(file="data/eval_dataset/teach_ch2.txt" timeoffset=0 timescale=1
+ amploffset=[0] amplscale=[1.0] timerelative=false amplstep=false)
a6 %v[vg_2] fsrc6
.model fsrc7 filesource(file="data/eval_dataset/teach_ch3.txt" timeoffset=0 timescale=1
+ amploffset=[0] amplscale=[1.0] timerelative=false amplstep=false)
a7 %v[vg_3] fsrc7
.model fsrc8 filesource(file="data/eval_dataset/teach_ch4.txt" timeoffset=0 timescale=1
+ amploffset=[0] amplscale=[1.0] timerelative=false amplstep=false)
a8 %v[vg_4] fsrc8
.model fsrc9 filesource(file="data/eval_dataset/teach_ch5.txt" timeoffset=0 timescale=1
+ amploffset=[0] amplscale=[1.0] timerelative=false amplstep=false)
a9 %v[vg_5] fsrc9
.model fsrc10 filesource(file="data/eval_dataset/teach_ch6.txt" timeoffset=0 timescale=1
+ amploffset=[0] amplscale=[1.0] timerelative=false amplstep=false)
a10 %v[vg_6] fsrc10
.control
save all
tran 1000us 600ms uic
plot i(Vmeas_in_1) i(Vmeas_in_2) i(Vmeas_in_3) i(Vmeas_in_4) i(Vmeas_in_5) i(Vmeas_in_6)
plot v(vand_1) v(vand_2) v(vand_3) v(vand_4) v(vand_5) v(vand_6)
plot v(vout_1) v(vout_2) v(vout_3) v(vout_4) v(vout_5) v(vout_6)
.endc


**** end user architecture code
**.ends

* expanding   symbol:  /media/sf_share/Highpass_500Hz.sym # of pins=4
* sym_path: /media/sf_share/Highpass_500Hz.sym
* sch_path: /media/sf_share/Highpass_500Hz.sch
.subckt Highpass_500Hz  vinput vout HPbias VREF
*.ipin vinput
*.ipin HPbias
*.ipin VREF
*.opin vout
C1 net1 vinput 1pf m=1
C2 vout net1 1pf m=1
X4 VREF vout vout HPbias transamp_1
X5 vout net1 net1 HPbias transamp_1
.ends


* expanding   symbol:  /media/sf_share/Lowpass_2500Hz.sym # of pins=4
* sym_path: /media/sf_share/Lowpass_2500Hz.sym
* sch_path: /media/sf_share/Lowpass_2500Hz.sch
.subckt Lowpass_2500Hz  LPbias2 vinput vout LPbias1
*.ipin vinput
*.ipin LPbias2
*.ipin LPbias1
*.opin vout
X1 vinput net1 net1 LPbias1 transamp_1
X2 net1 vout vout LPbias1 transamp_1
X3 net1 vout net1 LPbias2 transamp_1
C3 GND net1 1pf m=1
C4 GND vout 1pf m=1
.ends


* expanding   symbol:  /media/sf_share/final_project/schmitt_trigger.sym # of pins=2
* sym_path: /media/sf_share/final_project/schmitt_trigger.sym
* sch_path: /media/sf_share/final_project/schmitt_trigger.sch
.subckt schmitt_trigger  vout vin
*.ipin vin
*.opin vout
XM1 net1 vin net3 GND sky130_fd_pr__nfet_g5v0d10v5 L=1 W=15 nf=1 ad='int((nf+1)/2) * W/nf * 0.29' as='int((nf+2)/2) * W/nf * 0.29'
+ pd='2*int((nf+1)/2) * (W/nf + 0.29)' ps='2*int((nf+2)/2) * (W/nf + 0.29)' nrd='0.29 / W' nrs='0.29 / W'
+ sa=0 sb=0 sd=0 mult=1 m=1 
XM2 net1 vin net2 VDD sky130_fd_pr__pfet_g5v0d10v5 L=1 W=15 nf=1 ad='int((nf+1)/2) * W/nf * 0.29' as='int((nf+2)/2) * W/nf * 0.29'
+ pd='2*int((nf+1)/2) * (W/nf + 0.29)' ps='2*int((nf+2)/2) * (W/nf + 0.29)' nrd='0.29 / W' nrs='0.29 / W'
+ sa=0 sb=0 sd=0 mult=1 m=1 
XM3 net2 vin VDD VDD sky130_fd_pr__pfet_g5v0d10v5 L=1 W=1.5 nf=1 ad='int((nf+1)/2) * W/nf * 0.29' as='int((nf+2)/2) * W/nf * 0.29'
+ pd='2*int((nf+1)/2) * (W/nf + 0.29)' ps='2*int((nf+2)/2) * (W/nf + 0.29)' nrd='0.29 / W' nrs='0.29 / W'
+ sa=0 sb=0 sd=0 mult=1 m=1 
XM4 net3 vin GND GND sky130_fd_pr__nfet_g5v0d10v5 L=1 W=1.05 nf=1 ad='int((nf+1)/2) * W/nf * 0.29' as='int((nf+2)/2) * W/nf * 0.29'
+ pd='2*int((nf+1)/2) * (W/nf + 0.29)' ps='2*int((nf+2)/2) * (W/nf + 0.29)' nrd='0.29 / W' nrs='0.29 / W'
+ sa=0 sb=0 sd=0 mult=1 m=1 
XM5 GND net1 net2 VDD sky130_fd_pr__pfet_g5v0d10v5 L=15 W=1 nf=1 ad='int((nf+1)/2) * W/nf * 0.29' as='int((nf+2)/2) * W/nf * 0.29'
+ pd='2*int((nf+1)/2) * (W/nf + 0.29)' ps='2*int((nf+2)/2) * (W/nf + 0.29)' nrd='0.29 / W' nrs='0.29 / W'
+ sa=0 sb=0 sd=0 mult=1 m=1 
XM6 VDD net1 net3 GND sky130_fd_pr__nfet_g5v0d10v5 L=5.5 W=1 nf=1 ad='int((nf+1)/2) * W/nf * 0.29' as='int((nf+2)/2) * W/nf * 0.29'
+ pd='2*int((nf+1)/2) * (W/nf + 0.29)' ps='2*int((nf+2)/2) * (W/nf + 0.29)' nrd='0.29 / W' nrs='0.29 / W'
+ sa=0 sb=0 sd=0 mult=1 m=1 
x1 vout net1 inverter
.ends


* expanding   symbol:  /media/sf_share/final_project/cap_mem.sym # of pins=6
* sym_path: /media/sf_share/final_project/cap_mem.sym
* sch_path: /media/sf_share/final_project/cap_mem.sch
.subckt cap_mem  vmem vg vin vbias vbias1 vbias2
*.ipin vg
*.ipin vin
*.ipin vbias
*.opin vmem
*.ipin vbias1
*.ipin vbias2
*.ipin vreset
XM1 net1 net3 VDD VDD sky130_fd_pr__pfet_g5v0d10v5 L=0.5 W=0.5 nf=1 ad='int((nf+1)/2) * W/nf * 0.29'
+ as='int((nf+2)/2) * W/nf * 0.29' pd='2*int((nf+1)/2) * (W/nf + 0.29)' ps='2*int((nf+2)/2) * (W/nf + 0.29)'
+ nrd='0.29 / W' nrs='0.29 / W' sa=0 sb=0 sd=0 mult=1 m=1 
C2 net1 GND 10p m=1
X2 net1 net2 net3 vbias transamp_1
x2 vin net2 vg transmission_gate
XM2 vmem vg_bar net5 net4 sky130_fd_pr__pfet_g5v0d10v5 L=1 W=1 nf=1 ad='int((nf+1)/2) * W/nf * 0.29'
+ as='int((nf+2)/2) * W/nf * 0.29' pd='2*int((nf+1)/2) * (W/nf + 0.29)' ps='2*int((nf+2)/2) * (W/nf + 0.29)'
+ nrd='0.29 / W' nrs='0.29 / W' sa=0 sb=0 sd=0 mult=1 m=1 
X1 vmem net4 net4 vbias2 transamp_1
C1 vmem GND 1p m=1
X3 net1 net5 net5 vbias1 transamp_1
x3 vg_bar vg inverter
x4 net1 net1 vg transmission_gate
.ends


* expanding   symbol:  /media/sf_share/final_project/nxor.sym # of pins=3
* sym_path: /media/sf_share/final_project/nxor.sym
* sch_path: /media/sf_share/final_project/nxor.sch
.subckt nxor  a vout b
*.ipin a
*.ipin b
*.opin vout
XM2 net1 a VDD VDD sky130_fd_pr__pfet_g5v0d10v5 L=1 W=1 nf=1 ad='int((nf+1)/2) * W/nf * 0.29' as='int((nf+2)/2) * W/nf * 0.29'
+ pd='2*int((nf+1)/2) * (W/nf + 0.29)' ps='2*int((nf+2)/2) * (W/nf + 0.29)' nrd='0.29 / W' nrs='0.29 / W'
+ sa=0 sb=0 sd=0 mult=1 m=1 
XM3 net1 b VDD VDD sky130_fd_pr__pfet_g5v0d10v5 L=1 W=1 nf=1 ad='int((nf+1)/2) * W/nf * 0.29' as='int((nf+2)/2) * W/nf * 0.29'
+ pd='2*int((nf+1)/2) * (W/nf + 0.29)' ps='2*int((nf+2)/2) * (W/nf + 0.29)' nrd='0.29 / W' nrs='0.29 / W'
+ sa=0 sb=0 sd=0 mult=1 m=1 
XM8 net4 b GND GND sky130_fd_pr__nfet_g5v0d10v5 L=1 W=1 nf=1 ad='int((nf+1)/2) * W/nf * 0.29' as='int((nf+2)/2) * W/nf * 0.29'
+ pd='2*int((nf+1)/2) * (W/nf + 0.29)' ps='2*int((nf+2)/2) * (W/nf + 0.29)' nrd='0.29 / W' nrs='0.29 / W'
+ sa=0 sb=0 sd=0 mult=1 m=1 
XM7 net2 a net4 GND sky130_fd_pr__nfet_g5v0d10v5 L=1 W=1 nf=1 ad='int((nf+1)/2) * W/nf * 0.29' as='int((nf+2)/2) * W/nf * 0.29'
+ pd='2*int((nf+1)/2) * (W/nf + 0.29)' ps='2*int((nf+2)/2) * (W/nf + 0.29)' nrd='0.29 / W' nrs='0.29 / W'
+ sa=0 sb=0 sd=0 mult=1 m=1 
XM1 net2 b_bar net1 VDD sky130_fd_pr__pfet_g5v0d10v5 L=1 W=1 nf=1 ad='int((nf+1)/2) * W/nf * 0.29' as='int((nf+2)/2) * W/nf * 0.29'
+ pd='2*int((nf+1)/2) * (W/nf + 0.29)' ps='2*int((nf+2)/2) * (W/nf + 0.29)' nrd='0.29 / W' nrs='0.29 / W'
+ sa=0 sb=0 sd=0 mult=1 m=1 
XM4 net1 a_bar net2 VDD sky130_fd_pr__pfet_g5v0d10v5 L=1 W=1 nf=1 ad='int((nf+1)/2) * W/nf * 0.29' as='int((nf+2)/2) * W/nf * 0.29'
+ pd='2*int((nf+1)/2) * (W/nf + 0.29)' ps='2*int((nf+2)/2) * (W/nf + 0.29)' nrd='0.29 / W' nrs='0.29 / W'
+ sa=0 sb=0 sd=0 mult=1 m=1 
XM5 net2 a_bar net3 GND sky130_fd_pr__nfet_g5v0d10v5 L=1 W=1 nf=1 ad='int((nf+1)/2) * W/nf * 0.29' as='int((nf+2)/2) * W/nf * 0.29'
+ pd='2*int((nf+1)/2) * (W/nf + 0.29)' ps='2*int((nf+2)/2) * (W/nf + 0.29)' nrd='0.29 / W' nrs='0.29 / W'
+ sa=0 sb=0 sd=0 mult=1 m=1 
XM6 net3 b_bar GND GND sky130_fd_pr__nfet_g5v0d10v5 L=1 W=1 nf=1 ad='int((nf+1)/2) * W/nf * 0.29' as='int((nf+2)/2) * W/nf * 0.29'
+ pd='2*int((nf+1)/2) * (W/nf + 0.29)' ps='2*int((nf+2)/2) * (W/nf + 0.29)' nrd='0.29 / W' nrs='0.29 / W'
+ sa=0 sb=0 sd=0 mult=1 m=1 
x5 net5 net2 inverter
x6 VDD vout net5 transmission_gate
C1 vout GND 10f m=1
x7 b_bar b inverter
x8 a_bar a inverter
.ends
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
