YihuiCalm/Neural_Spike_Detection_and_Sorting_Circuit/schematics/simulation/top_tb.spice

**.subckt top_tb
V2 VDD GND 5.0
V5 HPbias GND 0.4
V6 VREF GND 2.0
V3 LPbias1 GND 0.543v
V4 LPbias2 GND 0.4v
Vbias vbias GND 1v
Vbias2 vleak GND 0.32v
Vbias3 vbias1 GND 0.6v
Vbias4 vbias2 GND 1.1v
XM3 net2 vmem_1_1 net5 GND sky130_fd_pr__nfet_g5v0d10v5 L=1 W=1 nf=1 ad='int((nf+1)/2) * W/nf * 0.29'
+ as='int((nf+2)/2) * W/nf * 0.29' pd='2*int((nf+1)/2) * (W/nf + 0.29)' ps='2*int((nf+2)/2) * (W/nf + 0.29)'
+ nrd='0.29 / W' nrs='0.29 / W' sa=0 sb=0 sd=0 mult=1 m=1 
XM4 VDD vspike_1 net1 GND sky130_fd_pr__nfet_g5v0d10v5 L=1 W=1 nf=1 ad='int((nf+1)/2) * W/nf * 0.29'
+ as='int((nf+2)/2) * W/nf * 0.29' pd='2*int((nf+1)/2) * (W/nf + 0.29)' ps='2*int((nf+2)/2) * (W/nf + 0.29)'
+ nrd='0.29 / W' nrs='0.29 / W' sa=0 sb=0 sd=0 mult=1 m=1 
XM6 net5 vspike_1 net1 GND sky130_fd_pr__nfet_g5v0d10v5 L=1 W=1 nf=1 ad='int((nf+1)/2) * W/nf * 0.29'
+ as='int((nf+2)/2) * W/nf * 0.29' pd='2*int((nf+1)/2) * (W/nf + 0.29)' ps='2*int((nf+2)/2) * (W/nf + 0.29)'
+ nrd='0.29 / W' nrs='0.29 / W' sa=0 sb=0 sd=0 mult=1 m=1 
XM7 VDD vmem_1_1 net1 GND sky130_fd_pr__nfet_g5v0d10v5 L=1 W=1 nf=1 ad='int((nf+1)/2) * W/nf * 0.29'
+ as='int((nf+2)/2) * W/nf * 0.29' pd='2*int((nf+1)/2) * (W/nf + 0.29)' ps='2*int((nf+2)/2) * (W/nf + 0.29)'
+ nrd='0.29 / W' nrs='0.29 / W' sa=0 sb=0 sd=0 mult=1 m=1 
XM1 net1 vbias_bump GND GND sky130_fd_pr__nfet_g5v0d10v5 L=1 W=1 nf=1 ad='int((nf+1)/2) * W/nf * 0.29'
+ as='int((nf+2)/2) * W/nf * 0.29' pd='2*int((nf+1)/2) * (W/nf + 0.29)' ps='2*int((nf+2)/2) * (W/nf + 0.29)'
+ nrd='0.29 / W' nrs='0.29 / W' sa=0 sb=0 sd=0 mult=1 m=1 
XM2 WTAin_1 net2 VDD VDD sky130_fd_pr__pfet_g5v0d10v5 L=1 W=1 nf=1 ad='int((nf+1)/2) * W/nf * 0.29' as='int((nf+2)/2) * W/nf * 0.29'
+ pd='2*int((nf+1)/2) * (W/nf + 0.29)' ps='2*int((nf+2)/2) * (W/nf + 0.29)' nrd='0.29 / W' nrs='0.29 / W'
+ sa=0 sb=0 sd=0 mult=1 m=1 
XM5 net2 net2 VDD VDD sky130_fd_pr__pfet_g5v0d10v5 L=1 W=1 nf=1 ad='int((nf+1)/2) * W/nf * 0.29' as='int((nf+2)/2) * W/nf * 0.29'
+ pd='2*int((nf+1)/2) * (W/nf + 0.29)' ps='2*int((nf+2)/2) * (W/nf + 0.29)' nrd='0.29 / W' nrs='0.29 / W'
+ sa=0 sb=0 sd=0 mult=1 m=1 
XM10 net3 net4 GND GND sky130_fd_pr__nfet_g5v0d10v5 L=1 W=1 nf=1 ad='int((nf+1)/2) * W/nf * 0.29' as='int((nf+2)/2) * W/nf * 0.29'
+ pd='2*int((nf+1)/2) * (W/nf + 0.29)' ps='2*int((nf+2)/2) * (W/nf + 0.29)' nrd='0.29 / W' nrs='0.29 / W'
+ sa=0 sb=0 sd=0 mult=1 m=1 
XM11 VDD net3 net4 GND sky130_fd_pr__nfet_g5v0d10v5 L=1 W=1 nf=1 ad='int((nf+1)/2) * W/nf * 0.29' as='int((nf+2)/2) * W/nf * 0.29'
+ pd='2*int((nf+1)/2) * (W/nf + 0.29)' ps='2*int((nf+2)/2) * (W/nf + 0.29)' nrd='0.29 / W' nrs='0.29 / W'
+ sa=0 sb=0 sd=0 mult=1 m=1 
XM12 net4 vbias_WTA GND GND sky130_fd_pr__nfet_g5v0d10v5 L=1 W=1 nf=1 ad='int((nf+1)/2) * W/nf * 0.29'
+ as='int((nf+2)/2) * W/nf * 0.29' pd='2*int((nf+1)/2) * (W/nf + 0.29)' ps='2*int((nf+2)/2) * (W/nf + 0.29)'
+ nrd='0.29 / W' nrs='0.29 / W' sa=0 sb=0 sd=0 mult=1 m=1 
Vbias5 vbias_bump GND 1.2v
Vbias6 vbias_WTA GND 1.5v
x6 vin_1 net6 HPbias VREF Highpass_500Hz
x7 LPbias2 net6 vfilter_1 LPbias1 Lowpass_2500Hz
x8 vspike_1 vfilter_1 schmitt_trigger
x9 vin_2 net7 HPbias VREF Highpass_500Hz
x10 LPbias2 net7 vfilter_2 LPbias1 Lowpass_2500Hz
x11 vspike_2 vfilter_2 schmitt_trigger
x12 vin_3 net8 HPbias VREF Highpass_500Hz
x13 LPbias2 net8 vfilter_3 LPbias1 Lowpass_2500Hz
x14 vspike_3 vfilter_3 schmitt_trigger
x15 vin_4 net9 HPbias VREF Highpass_500Hz
x16 LPbias2 net9 vfilter_4 LPbias1 Lowpass_2500Hz
x17 vspike_4 vfilter_4 schmitt_trigger
x18 vmem_1_1 vg_1 vspike_1 vbias vleak vbias1 vbias2 cap_mem
x1 vmem_2_1 vg_1 vspike_2 vbias vleak vbias1 vbias2 cap_mem
x2 vmem_3_1 vg_1 vspike_3 vbias vleak vbias1 vbias2 cap_mem
x3 vmem_4_1 vg_1 vspike_4 vbias vleak vbias1 vbias2 cap_mem
x19 vmem_1_2 vg_2 vspike_1 vbias vleak vbias1 vbias2 cap_mem
x20 vmem_1_3 vg_3 vspike_1 vbias vleak vbias1 vbias2 cap_mem
x21 vmem_1_4 vg_4 vspike_1 vbias vleak vbias1 vbias2 cap_mem
x22 vmem_1_5 vg_5 vspike_1 vbias vleak vbias1 vbias2 cap_mem
x23 vmem_1_6 vg_6 vspike_1 vbias vleak vbias1 vbias2 cap_mem
x24 vmem_2_2 vg_2 vspike_2 vbias vleak vbias1 vbias2 cap_mem
x25 vmem_2_3 vg_3 vspike_2 vbias vleak vbias1 vbias2 cap_mem
x26 vmem_2_4 vg_4 vspike_2 vbias vleak vbias1 vbias2 cap_mem
x27 vmem_2_5 vg_5 vspike_2 vbias vleak vbias1 vbias2 cap_mem
x28 vmem_2_6 vg_6 vspike_2 vbias vleak vbias1 vbias2 cap_mem
x29 vmem_3_2 vg_2 vspike_3 vbias vleak vbias1 vbias2 cap_mem
x30 vmem_3_3 vg_3 vspike_3 vbias vleak vbias1 vbias2 cap_mem
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
XM101 VDD vspike_1 net49 GND sky130_fd_pr__nfet_g5v0d10v5 L=1 W=1 nf=1 ad='int((nf+1)/2) * W/nf * 0.29'
+ as='int((nf+2)/2) * W/nf * 0.29' pd='2*int((nf+1)/2) * (W/nf + 0.29)' ps='2*int((nf+2)/2) * (W/nf + 0.29)'
+ nrd='0.29 / W' nrs='0.29 / W' sa=0 sb=0 sd=0 mult=1 m=1 
XM102 net51 vspike_1 net49 GND sky130_fd_pr__nfet_g5v0d10v5 L=1 W=1 nf=1 ad='int((nf+1)/2) * W/nf * 0.29'
+ as='int((nf+2)/2) * W/nf * 0.29' pd='2*int((nf+1)/2) * (W/nf + 0.29)' ps='2*int((nf+2)/2) * (W/nf + 0.29)'
+ nrd='0.29 / W' nrs='0.29 / W' sa=0 sb=0 sd=0 mult=1 m=1
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
