YihuiCalm/Neural_Spike_Detection_and_Sorting_Circuit/(commit log)

2025-11-20 Revise README with project details and structure
    Updated the README to provide detailed project information, including objectives, system architecture, circuit modules, implementation metrics, and repository structure.
2025-11-20 First commit.
    [CS_amp.sch, CS_amp_tb.sch, amp_tb.sch, and.sch, and4_tb.sch, and5.sch, and_tb.sch, buffer.sch]
